TeamScheire/intel.letto/doc/scenario_wakeup_v01.jpg

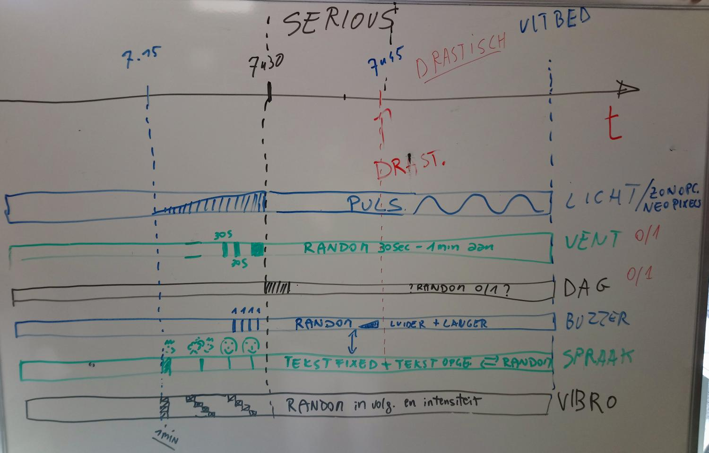
doc/scenario_wakeup_v01.jpg
