TeamScheire/intel.letto/alarmblanket/intelletto/buzzerYL44.h

 // Ingegno 01/2018
// Buzzer YL-44 with NodeMCU

// This is an active buzzer, it produces sound by itself without
// external frequency generator. Sound is in the audible 2 kHz range
// Taking the I/O pin LOW will turn the buzzer ON and taking this
// pin HIGH will turn the buzzer OFF (as will leaving this pin OPEN). 
// This device can be controlled by PWM.

// The buzzer is connected to NodeMCU pin D6. This pin has 3V3 login, so the I/O pin
// of the buzzer would always be LOW with buzzer on as only with 5V buzzer is off
//
// Solution: we add a BC547 NPN transistor on the GND pin of the YL-44. This
//           allows to connect the I/O pin of the YL-44 to the GND out of the
//           NodeMCU, and the VCC to the 5V pin. The D6 pin is connected to the 
//           Base of the BC547, the GND of the YL-44 is connected to the Emittor
//           (right) of the BC547, and the Collector is connected to the GND of 
//           NodeMCU.
//           It is possible to achieve softer sounds using PWM on the D6 pin

int beepstrength;
int beepDuration;
int beepDurationTotal;
int dotDuration;
int buzzer = D5;

// Deze functie beschrijven...
int ard_effect0_status = -1;
unsigned long ard_effect0_start, ard_effect0_time;
#define EFFECT0_PERIOD (dotDuration * 2)
#define EFFECT0_1_DURATION dotDuration


void dot() {
  //Variables of this effect are reffered to with ard_effect0
  boolean restart = false;
  ard_effect0_time = millis() - ard_effect0_start;
  if (ard_effect0_time > EFFECT0_PERIOD) {
    //end effect, make sure it restarts
    if (ard_effect0_status > -1) {
    //END STATEMENTS
      analogWrite(buzzer, 0);
    }
    restart = true;
    ard_effect0_status = -1;
    ard_effect0_start = ard_effect0_start + ard_effect0_time;
    ard_effect0_time = 0;
  }
  if (not restart && ard_effect0_status == -1) {
    ard_effect0_status = 0;
    ard_effect0_start = ard_effect0_start + ard_effect0_time;
    ard_effect0_time = 0;
  analogWrite(buzzer, beepstrength);
  }
  if (ard_effect0_time > EFFECT0_1_DURATION && ard_effect0_status < 1) {
   ard_effect0_status = 1;
  analogWrite(buzzer, 0);
  }
}


// Deze functie beschrijven...
int ard_effect1_status = -1;
unsigned long ard_effect1_start, ard_effect1_time;
#define EFFECT1_PERIOD (dotDuration * 4)
#define EFFECT1_1_DURATION dotDuration * 3

void dash() {
  //Variables of this effect are reffered to with ard_effect1
  boolean restart = false;
  ard_effect1_time = millis() - ard_effect1_start;
  if (ard_effect1_time > EFFECT1_PERIOD) {
    //end effect, make sure it restarts
    if (ard_effect1_status > -1) {
    //END STATEMENTS
      analogWrite(buzzer, 0);
    }
    restart = true;
    ard_effect1_status = -1;
    ard_effect1_start = ard_effect1_start + ard_effect1_time;
    ard_effect1_time = 0;
  }
  if (not restart && ard_effect1_status == -1) {
    ard_effect1_status = 0;
    ard_effect1_start = ard_effect1_start + ard_effect1_time;
    ard_effect1_time = 0;
  analogWrite(buzzer, beepstrength);
  }
  if (ard_effect1_time > EFFECT1_1_DURATION && ard_effect1_status < 1) {
   ard_effect1_status = 1;
  analogWrite(buzzer, 0);
  }
}


// Deze functie beschrijven...
int ard_effect2_status = -1;
unsigned long ard_effect2_start, ard_effect2_time;
#define EFFECT2_PERIOD (dotDuration * 3)

void letterpause() {
  //Variables of this effect are reffered to with ard_effect2
  boolean restart = false;
  ard_effect2_time = millis() - ard_effect2_start;
  if (ard_effect2_time > EFFECT2_PERIOD) {
    //end effect, make sure it restarts
    if (ard_effect2_status > -1) {
    //END STATEMENTS
      analogWrite(buzzer, 0);
    }
    restart = true;
    ard_effect2_status = -1;
    ard_effect2_start = ard_effect2_start + ard_effect2_time;
    ard_effect2_time = 0;
  }
  if (not restart && ard_effect2_status == -1) {
    ard_effect2_status = 0;
    ard_effect2_start = ard_effect2_start + ard_effect2_time;
    ard_effect2_time = 0;
  analogWrite(buzzer, 0);
  }
}


// Deze functie beschrijven...
int ard_effect3_status = -1;
unsigned long ard_effect3_start, ard_effect3_time;
#define EFFECT3_PERIOD (dotDuration * 33)
#define EFFECT3_1_DURATION dotDuration * 1
#define EFFECT3_2_DURATION dotDuration * 2
#define EFFECT3_3_DURATION dotDuration * 3
#define EFFECT3_4_DURATION dotDuration * 4
#define EFFECT3_5_DURATION dotDuration * 5
#define EFFECT3_6_DURATION dotDuration * 8
#define EFFECT3_7_DURATION dotDuration * 11
#define EFFECT3_8_DURATION dotDuration * 12
#define EFFECT3_9_DURATION dotDuration * 15
#define EFFECT3_10_DURATION dotDuration * 16
#define EFFECT3_11_DURATION dotDuration * 19
#define EFFECT3_12_DURATION dotDuration * 22
#define EFFECT3_13_DURATION dotDuration * 23
#define EFFECT3_14_DURATION dotDuration * 24
#define EFFECT3_15_DURATION dotDuration * 25
#define EFFECT3_16_DURATION dotDuration * 26
#define EFFECT3_17_DURATION dotDuration * 27

void SOS() {
  //Variables of this effect are reffered to with ard_effect3
  boolean restart = false;
  ard_effect3_time = millis() - ard_effect3_start;
  if (ard_effect3_time > EFFECT3_PERIOD) {
    //end effect, make sure it restarts
    if (ard_effect3_status > -1) {
    //END STATEMENTS
      analogWrite(buzzer, 0);
    }
    restart = true;
    ard_effect3_status = -1;
    ard_effect3_start = ard_effect3_start + ard_effect3_time;
    ard_effect3_time = 0;
  }
  if (not restart && ard_effect3_status == -1) {
    ard_effect3_status = 0;
    ard_effect3_start = ard_effect3_start + ard_effect3_time;
    ard_effect3_time = 0;
  analogWrite(buzzer, beepstrength);
  }
  if (ard_effect3_time > EFFECT3_1_DURATION && ard_effect3_status < 1) {
   ard_effect3_status = 1;
  analogWrite(buzzer, 0);
  } else if (ard_effect3_time > EFFECT3_2_DURATION && ard_effect3_status < 2) {
   ard_effect3_status = 2;
  analogWrite(buzzer, beepstrength);
  } else if (ard_effect3_time > EFFECT3_3_DURATION && ard_effect3_status < 3) {
   ard_effect3_status = 3;
  analogWrite(buzzer, 0);
  } else if (ard_effect3_time > EFFECT3_4_DURATION && ard_effect3_status < 4) {
   ard_effect3_status = 4;
  analogWrite(buzzer, beepstrength);
  } else if (ard_effect3_time > EFFECT3_5_DURATION && ard_effect3_status < 5) {
   ard_effect3_status = 5;
  analogWrite(buzzer, 0);
  } else if (ard_effect3_time > EFFECT3_6_DURATION && ard_effect3_status < 6) {
   ard_effect3_status = 6;
  analogWrite(buzzer, beepstrength);
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
  beepstrength = 120;
  analogWrite(buzzer, beepstrength);
  } else if (ard_effect5_time > EFFECT5_5_DURATION && ard_effect5_status < 5) {
   ard_effect5_status = 5;
  beepstrength = 20;
  analogWrite(buzzer, 0);
  } else if (ard_effect5_time > EFFECT5_6_DURATION && ard_effect5_status < 6) {
   ard_effect5_status = 6;
  beepstrength = 50;
  analogWrite(buzzer, beepstrength);
  } else if (ard_effect5_time > EFFECT5_7_DURATION && ard_effect5_status < 7) {
   ard_effect5_status = 7;
  beepstrength = 20;
  analogWrite(buzzer, 0);
  } else if (ard_effect5_time > EFFECT5_8_DURATION && ard_effect5_status < 8) {
   ard_effect5_status = 8;
  beepstrength = 180;
  analogWrite(buzzer, beepstrength);
  }
}

void setup_buzzer() {
  
  pinMode(buzzer, OUTPUT);
  ard_effect0_status = -1;
  ard_effect0_start = millis();

  ard_effect1_status = -1;
  ard_effect1_start = millis();

  ard_effect2_status = -1;
  ard_effect2_start = millis();

  ard_effect3_status = -1;
  ard_effect3_start = millis();

  ard_effect4_status = -1;
  ard_effect4_start = millis();

  ard_effect5_status = -1;
  ard_effect5_start = millis();

  beepstrength = 255;
  beepDuration = 250;
  beepDurationTotal = 250;
  dotDuration = 250;
}
