TeamScheire/intel.letto/alarmblanket/intelletto/neopattern.h

 #include <Adafruit_NeoPixel.h>
 
// Pattern types supported:
enum  pattern { NONE, RAINBOW_CYCLE, THEATER_CHASE, COLOR_WIPE, SCANNER, FADE };
// Patern directions supported:
enum  direction { FORWARD, REVERSE };

int dageraad1len = 256;
uint8_t dageraad1[ 256 ][ 3 ] = {
  {0,0,0},{3,2,1},{6,4,2},{9,6,3},{12,8,4},{15,10,5},{18,13,5},
  {21,15,6},{24,17,7},{27,19,8},{29,21,9},{32,23,10},{35,25,11},
  {38,27,12},{41,29,13},{44,31,14},{47,33,15},{50,35,15},{53,38,16},
  {56,40,17},{59,42,18},{62,44,19},{65,46,20},{68,48,21},{71,50,22},
  {74,52,23},{77,54,24},{80,56,25},{82,58,25},{85,60,26},{88,63,27},
  {91,65,28},{94,67,29},{97,69,30},{100,71,31},{103,73,32},{106,75,33},
  {109,77,34},{112,79,35},{115,81,35},{118,83,36},{121,85,37},{124,88,38},
  {127,90,39},{130,92,40},{133,94,41},{135,96,42},{138,98,43},{141,100,44},
  {144,102,45},{147,104,45},{150,106,46},{153,108,47},{156,110,48},{159,113,49},
  {162,115,50},{165,117,51},{168,119,52},{171,121,53},{174,123,54},{177,125,55},
  {180,127,55},{183,129,56},{186,131,57},{188,133,58},{189,134,59},{190,136,60},
  {191,137,62},{192,138,63},{192,139,64},{193,141,65},{194,142,66},{195,143,67},
  {196,144,68},{197,146,69},{198,147,70},{199,148,72},{200,149,73},{201,151,74},
  {201,152,75},{202,153,76},{203,154,77},{204,155,78},{205,157,79},{206,158,81},
  {207,159,82},{208,160,83},{209,162,84},{210,163,85},{210,164,86},{211,165,87},
  {212,167,88},{213,168,89},{214,169,91},{215,170,92},{216,172,93},{217,173,94},
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
  {199,150,121},{199,150,123},{198,150,124},{198,150,125},{197,150,127},{196,150,128},{196,150,129},
  {195,150,130},{195,150,132},{194,150,133},{193,150,134},{193,150,136},{192,150,137},{192,150,138},
  {191,150,139},{191,150,141},{190,150,142},{189,150,143},{189,150,145},{188,150,146},{188,150,147},
  {187,150,149},{186,150,150},{186,150,151},{185,150,152},{185,150,154},{184,150,155},{184,150,156},
  {183,150,158},{182,150,159},{182,150,160},{181,150,162},{181,150,163},{180,150,164},{179,150,165},
  {179,150,167},{178,150,168},{178,150,169},{177,150,171},{176,150,172},{176,150,173},{175,150,174},
  {175,150,176},{174,150,177},{174,150,178},{173,150,180},{172,150,181},{172,150,182},{171,150,184},
  {171,150,185},{170,150,186},{169,150,187},{169,150,189},{168,150,190},{168,150,191},{167,150,193},
  {167,150,194},{166,150,195},{165,150,197},{165,150,198},{164,150,199},{164,150,200},{163,150,202},
  {162,150,203},{162,150,204},{161,150,206},{161,150,207},{160,150,208},{159,150,209},{159,150,211},
  {158,150,212},{158,150,213},{157,150,215},{157,150,216},{156,150,217},{155,150,219},{155,150,220},
  {154,150,221},{154,150,222},{153,150,224},{152,150,225},{152,150,226},{151,150,228},{151,150,229},
  {150,150,230},{150,150,232},{149,149,233},{148,148,234},{147,147,235},{146,146,236},{145,145,237},
  {144,144,238},{142,142,240},{141,141,241},{140,140,242},{139,139,243},{138,138,244},{137,137,245},
  {136,136,246},{135,135,247},{134,134,248},{133,133,249},{132,132,250},{131,131,251},{130,130,252},
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
  };

// NeoPattern Class - derived from the Adafruit_NeoPixel class
class NeoPatterns : public Adafruit_NeoPixel
{
    public:
 
    // Member Variables:  
    pattern  ActivePattern;  // which pattern is running
    direction Direction;     // direction to run the pattern
    
    unsigned long Interval;   // milliseconds between updates
    unsigned long lastUpdate; // last update of position
    
    uint32_t Color1, Color2;  // What colors are in use
    uint16_t TotalSteps;  // total number of steps in the pattern
    uint16_t Index;  // current step within the pattern
    
    void (*OnComplete)();  // Callback on completion of pattern
    
    // Constructor - calls base-class constructor to initialize strip
    NeoPatterns(uint16_t pixels, uint8_t pin, uint8_t type, void (*callback)())
    :Adafruit_NeoPixel(pixels, pin, type)
    {
        OnComplete = callback;
    }
    
    // Update the pattern
    void Update()
    {
        if((millis() - lastUpdate) > Interval) // time to update
        {
            lastUpdate = millis();
            switch(ActivePattern)
            {
                case RAINBOW_CYCLE:
                    RainbowCycleUpdate();
                    break;
                case THEATER_CHASE:
                    TheaterChaseUpdate();
                    break;
                case COLOR_WIPE:
                    ColorWipeUpdate();
                    break;
                case SCANNER:
                    ScannerUpdate();
                    break;
                case FADE:
                    FadeUpdate();
                    break;
                default:
                    break;
            }
        }
    }
  
    // Increment the Index and reset at the end
    void Increment()
    {
        if (Direction == FORWARD)
        {
           Index++;
           if (Index >= TotalSteps)
            {
                Index = 0;
                if (OnComplete != NULL)
                {
                    OnComplete(); // call the comlpetion callback
                }
            }
        }
        else // Direction == REVERSE
        {
            --Index;
            if (Index <= 0)
            {
                Index = TotalSteps-1;
                if (OnComplete != NULL)
                {
                    OnComplete(); // call the comlpetion callback
                }
            }
        }
    }
    
    // Reverse pattern direction
    void Reverse()
    {
        if (Direction == FORWARD)
        {
            Direction = REVERSE;
            Index = TotalSteps-1;
        }
        else
        {
            Direction = FORWARD;
            Index = 0;
        }
    }
    
    // Initialize for a RainbowCycle
    void RainbowCycle(uint8_t interval, direction dir = FORWARD)
    {
        ActivePattern = RAINBOW_CYCLE;
        Interval = interval;
        TotalSteps = 255;
        Index = 0;
        Direction = dir;
    }
    
    // Update the Rainbow Cycle Pattern
    void RainbowCycleUpdate()
    {
        for(int i=0; i< numPixels(); i++)
        {
            setPixelColor(i, Wheel(((i * 256 / numPixels()) + Index) & 255));
        }
        show();
        Increment();
    }
 
    // Initialize for a Theater Chase
    void TheaterChase(uint32_t color1, uint32_t color2, uint8_t interval, direction dir = FORWARD)
    {
        ActivePattern = THEATER_CHASE;
        Interval = interval;
        TotalSteps = numPixels();
        Color1 = color1;
        Color2 = color2;
        Index = 0;
        Direction = dir;
   }
    
    // Update the Theater Chase Pattern
    void TheaterChaseUpdate()
    {
        for(int i=0; i< numPixels(); i++)
        {
            if ((i + Index) % 3 == 0)
            {
                setPixelColor(i, Color1);
            }
            else
            {
                setPixelColor(i, Color2);
            }
        }
        show();
        Increment();
    }
 
    // Initialize for a ColorWipe
    void ColorWipe(uint32_t color, uint8_t interval, direction dir = FORWARD)
    {
        ActivePattern = COLOR_WIPE;
        Interval = interval;
        TotalSteps = numPixels();
        Color1 = color;
        Index = 0;
        Direction = dir;
    }
    
    // Update the Color Wipe Pattern
    void ColorWipeUpdate()
    {
        setPixelColor(Index, Color1);
        show();
        Increment();
    }
    
    // Initialize for a SCANNNER
    void Scanner(uint32_t color1, uint8_t interval)
    {
        ActivePattern = SCANNER;
        Interval = interval;
        TotalSteps = (numPixels() - 1) * 2;
        Color1 = color1;
        Index = 0;
    }
 
    // Update the Scanner Pattern
    void ScannerUpdate()
    { 
        for (int i = 0; i < numPixels(); i++)
        {
            if (i == Index)  // Scan Pixel to the right
            {
                 setPixelColor(i, Color1);
            }
            else if (i == TotalSteps - Index) // Scan Pixel to the left
            {
                 setPixelColor(i, Color1);
            }
            else // Fading tail
            {
                 setPixelColor(i, DimColor(getPixelColor(i)));
            }
        }
        show();
        Increment();
    }
    
    // Initialize for a Fade
    void Fade(uint32_t color1, uint32_t color2, uint16_t steps, uint8_t interval, direction dir = FORWARD)
    {
        ActivePattern = FADE;
        Interval = interval;
        TotalSteps = steps;
        Color1 = color1;
        Color2 = color2;
        Index = 0;
        Direction = dir;
    }
    
    // Update the Fade Pattern
    void FadeUpdate()
    {
        // Calculate linear interpolation between Color1 and Color2
        // Optimise order of operations to minimize truncation error
        uint8_t red = ((Red(Color1) * (TotalSteps - Index)) + (Red(Color2) * Index)) / TotalSteps;
        uint8_t green = ((Green(Color1) * (TotalSteps - Index)) + (Green(Color2) * Index)) / TotalSteps;
        uint8_t blue = ((Blue(Color1) * (TotalSteps - Index)) + (Blue(Color2) * Index)) / TotalSteps;
        
        ColorSet(Color(red, green, blue));
        //show();
        Increment();
    }
   
    // Calculate 50% dimmed version of a color (used by ScannerUpdate)
    uint32_t DimColor(uint32_t color)
    {
        // Shift R, G and B components one bit to the right
        uint32_t dimColor = Color(Red(color) >> 1, Green(color) >> 1, Blue(color) >> 1);
        return dimColor;
    }
 
    // Set all pixels to a color (synchronously)
    void ColorSet(uint32_t color)
    {
        for (int i = 0; i < numPixels(); i++)
        {
            setPixelColor(i, color);
        }
        show();
    }
 
    // Returns the Red component of a 32-bit color
    uint8_t Red(uint32_t color)
    {
        return (color >> 16) & 0xFF;
    }
 
    // Returns the Green component of a 32-bit color
    uint8_t Green(uint32_t color)
    {
        return (color >> 8) & 0xFF;
    }
 
    // Returns the Blue component of a 32-bit color
    uint8_t Blue(uint32_t color)
    {
        return color & 0xFF;
    }
    
    // Input a value 0 to 255 to get a color value.
    // The colours are a transition r - g - b - back to r.
    uint32_t Wheel(byte WheelPos)
    {
        WheelPos = 255 - WheelPos;
        if(WheelPos < 85)
        {
            return Color(255 - WheelPos * 3, 0, WheelPos * 3);
        }
        else if(WheelPos < 170)
        {
            WheelPos -= 85;
            return Color(0, WheelPos * 3, 255 - WheelPos * 3);
        }
        else
        {
            WheelPos -= 170;
            return Color(WheelPos * 3, 255 - WheelPos * 3, 0);
        }
    }
};
// 
//void Ring1Complete();
//void Ring2Complete();
//void StickComplete();
// 
//// Define some NeoPatterns for the two rings and the stick
////  as well as some completion routines
//NeoPatterns Ring1(24, 5, NEO_GRB + NEO_KHZ800, &Ring1Complete);
//NeoPatterns Ring2(16, 6, NEO_GRB + NEO_KHZ800, &Ring2Complete);
//NeoPatterns Stick(16, 7, NEO_GRB + NEO_KHZ800, &StickComplete);

 
//// Main loop
//void loop()
//{
//    // Update the rings.
//    Ring1.Update();
//    Ring2.Update();    
//    
//    // Switch patterns on a button press:
//    if (digitalRead(8) == LOW) // Button #1 pressed
//    {
//        // Switch Ring1 to FADE pattern
//        Ring1.ActivePattern = FADE;
//        Ring1.Interval = 20;
//        // Speed up the rainbow on Ring2
//        Ring2.Interval = 0;
//        // Set stick to all red
//        Stick.ColorSet(Stick.Color(255, 0, 0));
//    }
//    else if (digitalRead(9) == LOW) // Button #2 pressed
//    {
//        // Switch to alternating color wipes on Rings1 and 2
//        Ring1.ActivePattern = COLOR_WIPE;
//        Ring2.ActivePattern = COLOR_WIPE;
//        Ring2.TotalSteps = Ring2.numPixels();
//        // And update tbe stick
//        Stick.Update();
//    }
//    else // Back to normal operation
//    {
//        // Restore all pattern parameters to normal values
//        Ring1.ActivePattern = THEATER_CHASE;
//        Ring1.Interval = 100;
//        Ring2.ActivePattern = RAINBOW_CYCLE;
//        Ring2.TotalSteps = 255;
//        Ring2.Interval = min(10, Ring2.Interval);
//        // And update tbe stick
//        Stick.Update();
//    }    
//}
 
//------------------------------------------------------------
//Completion Routines - get called on completion of a pattern
//------------------------------------------------------------
// 
//// Ring1 Completion Callback
//void Ring1Complete()
//{
//    if (digitalRead(9) == LOW)  // Button #2 pressed
//    {
//        // Alternate color-wipe patterns with Ring2
//        Ring2.Interval = 40;
//        Ring1.Color1 = Ring1.Wheel(random(255));
//        Ring1.Interval = 20000;
//    }
//    else  // Retrn to normal
//    {
//      Ring1.Reverse();
//    }
//}
// 
//// Ring 2 Completion Callback
//void Ring2Complete()
//{
//    if (digitalRead(9) == LOW)  // Button #2 pressed
//    {
//        // Alternate color-wipe patterns with Ring1
//        Ring1.Interval = 20;
//        Ring2.Color1 = Ring2.Wheel(random(255));
//        Ring2.Interval = 20000;
//    }
//    else  // Retrn to normal
//    {
//        Ring2.RainbowCycle(random(0,10));
//    }
//}
// 
//// Stick Completion Callback
//void StickComplete()
//{
//    // Random color change for next scan
//    Stick.Color1 = Stick.Wheel(random(255));
//}
