TeamScheire/intel.letto/alarmblanket/intelletto_inbed_detector/inbed_detector/mpr121.h

/*
    MPR121.h
	April 8, 2010
	by: Jim Lindblom
*/

// MPR121 Register Defines
#define MHD_R	0x2B
#define NHD_R	0x2C
#define	NCL_R 	0x2D
#define	FDL_R	0x2E
#define	MHD_F	0x2F
#define	NHD_F	0x30
#define	NCL_F	0x31
#define	FDL_F	0x32
#define	ELE0_T	0x41
#define	ELE0_R	0x42
#define	ELE1_T	0x43
#define	ELE1_R	0x44
#define	ELE2_T	0x45
#define	ELE2_R	0x46
#define	ELE3_T	0x47
#define	ELE3_R	0x48
#define	ELE4_T	0x49
#define	ELE4_R	0x4A
#define	ELE5_T	0x4B
#define	ELE5_R	0x4C
#define	ELE6_T	0x4D
#define	ELE6_R	0x4E
#define	ELE7_T	0x4F
#define	ELE7_R	0x50
#define	ELE8_T	0x51
#define	ELE8_R	0x52
#define	ELE9_T	0x53
#define	ELE9_R	0x54
#define	ELE10_T	0x55
#define	ELE10_R	0x56
#define	ELE11_T	0x57
#define	ELE11_R	0x58
#define	FIL_CFG	0x5D
#define	ELE_CFG	0x5E
#define GPIO_CTRL0	0x73
#define	GPIO_CTRL1	0x74
#define GPIO_DATA	0x75
#define	GPIO_DIR	0x76
#define	GPIO_EN		0x77
#define	GPIO_SET	0x78
#define	GPIO_CLEAR	0x79
#define	GPIO_TOGGLE	0x7A
#define	ATO_CFG0	0x7B
#define	ATO_CFGU	0x7D
#define	ATO_CFGL	0x7E
#define	ATO_CFGT	0x7F


// Global Constants
// threshold is typically in the range 0x04~0x10. 
// The touch threshold should be several counts larger than the release threshold. 
#define TOU_THRESH	0x04 // 0x06
#define	REL_THRESH	0x02 // 0x0A  For us, release should be almost baseline

//Adafruit lib constants
#define MPR121_I2CADDR_DEFAULT 0x5A

#define MPR121_TOUCHSTATUS_L 0x00
#define MPR121_TOUCHSTATUS_H 0x01
#define MPR121_FILTDATA_0L  0x04
#define MPR121_FILTDATA_0H  0x05
#define MPR121_BASELINE_0   0x1E
#define MPR121_MHDR         0x2B
#define MPR121_NHDR         0x2C
#define MPR121_NCLR         0x2D
#define MPR121_FDLR         0x2E
#define MPR121_MHDF         0x2F
#define MPR121_NHDF         0x30
#define MPR121_NCLF         0x31
#define MPR121_FDLF         0x32
#define MPR121_NHDT         0x33
#define MPR121_NCLT         0x34
#define MPR121_FDLT         0x35

#define MPR121_TOUCHTH_0    0x41
#define MPR121_RELEASETH_0    0x42
#define MPR121_DEBOUNCE 0x5B
#define MPR121_CONFIG1 0x5C
#define MPR121_CONFIG2 0x5D
#define MPR121_CHARGECURR_0 0x5F
#define MPR121_CHARGETIME_1 0x6C
#define MPR121_ECR 0x5E
#define MPR121_AUTOCONFIG0 0x7B
#define MPR121_AUTOCONFIG1 0x7C
#define MPR121_UPLIMIT   0x7D
#define MPR121_LOWLIMIT  0x7E
#define MPR121_TARGETLIMIT  0x7F

#define MPR121_GPIODIR  0x76
#define MPR121_GPIOEN  0x77
#define MPR121_GPIOSET  0x78
#define MPR121_GPIOCLR  0x79
#define MPR121_GPIOTOGGLE  0x7A

#define MPR121_SOFTRESET 0x80
