TeamScheire/intel.letto/(commit log)

2018-01-27 buzzer with btn to select tune and no delay
    [BuzzerYL44_btn_nodelay.ino]
2018-01-28 Example of good working wifi on nodemcu + webserver + I2C to Arduino slave
2018-01-28 sunrise and buzzer alarm test code
    [Alarm_clock_sunrise_buzzer.ino, buzzerYL44.h, neopattern.h]
2018-02-01 keep track of a millis to alarm also
2018-02-01 1/ switch display off on long press 2/ different neopixel effects
2018-02-01 bugfixes: working neopixel patters and display switch off
    [Alarm_clock_sunrise_buzzer.ino, wifilib.h]
2018-02-01 Finalizing neopixel + buzzer alarm * use as lamp when no alarm * snooze function, buzzer variation * fade on alarmlight for safety in power comsumption
    [Alarm_clock_sunrise_buzzer.ino, buzzerYL44.h, neopattern.h, wakescenario.h]
2018-02-16 Test sketch van de controle van matras
2018-04-04 in bed sensor testing code
2018-04-04 bugfix: correct inbed determination
    [inbed_detector.ino, wifilib.h]
2018-04-05 Various bugfixes * working alarm set * working scenario's light + ventilator * correct in bed detection
    [intelletto.ino, pushbuttonlib.h, wakescenario.h, wifilib.h]
2018-04-27 Connect to raspberry pi as MQTT broker
    [inbed_detector.ino, intelletto.ino, massage_control_mqtt_MASTER_NODEMCU.ino]
2018-05-01 * Various bug fixes and improvements * Own NTPClient with bug fixes * set IP for NTP and MQTT to eth0 address of the rasp pi base station
    [inbed_detector.ino, intelletto.ino, massage_control_mqtt_MASTER_NODEMCU.ino, wake_loudspeaker.ino, wakescenario.h, wifilib.h]
2019-03-10 bugfix: hostapd_cli all_sta not working on current rasppi
