TeamScheire/intel.letto/(notices)

Notices in the files:
references/BedOccupancySensor/BedOccupancySensor.ino:
modify it under the terms of the GNU General Public License
